dario0603/Unipi_boost_converter/README.md

# DC-DC Boost Converter with Closed-Loop Control

<p align="left">
  
  
  
  
</p>

Academic project developed for the **University of Pisa** focused on the design, loss analysis, small-signal dynamic modeling, and closed-loop control of a high-efficiency **DC-DC Boost Converter**.

---

## Project Specifications

* **Input Voltage ($V_{\text{in}}$):** 3.3 V
* **Output Voltage ($V_{\text{out}}$):** 12.0 V
* **Reference Voltage ($V_{\text{ref}}$):** 3.3 V
* **PWM Peak/Ramp Voltage:** 1.0 V
* **Switching Frequency:** 600 kHz
* **Load Resistance Range ($R_o$):** $100\Omega$ to $1000\Omega$
* **Operation Mode:** Continuous Conduction Mode (CCM)
* **Output Voltage Ripple:** < 0.1 $\cdot V_{\text{out}} = 12\text{ mV}$
* **Target Efficiency:** > 70% (Achieved: 87.5% to 94.3%)
* **Steady-State DC Relative Error:** < 1%
* **50 Hz Relative Error:** < 10%

---

## Power Stage Design & Component Selection

The power stage was dimensioned in worst-case operating conditions to counteract component derating and parasitic effects:

* **Inductor ($L_1$):** Coilcraft RFS1317-334KL ($330\mu\text{H}$, $\text{ESR} = 286\text{ m}\Omega$), guaranteeing CCM operation up to $7.2\text{ k}\Omega$ load.
* **Capacitor ($C_1$):** Panasonic 100SXE18M ($18\mu\text{F}$, $\text{ESR} = 30\text{ m}\Omega$, $100\text{ V}$) to meet the output ripple constraint.
* **Transistor ($M_1$):** Infineon IRFH7921 N-Channel MOSFET ($V_{\text{DS,max}} = 30\text{ V}$, $R_{\text{DS(on)}} = 8.5\text{ m}\Omega$).
* **Diode ($D_1$):** Infineon BAS3005A-02V Schottky Diode ($I_{\text{max}} = 500\text{ mA}$, $V_{\gamma} \approx 0.5\text{ V}$, $R_D = 267\text{ m}\Omega$).

| Ideal Converter Schematic | Lossy Converter Schematic |
| :---: | :---: |
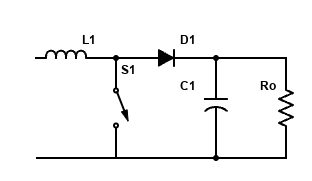
[picture p1: Relazione/img/Boost conv.png]
Ideal Boost Schematic
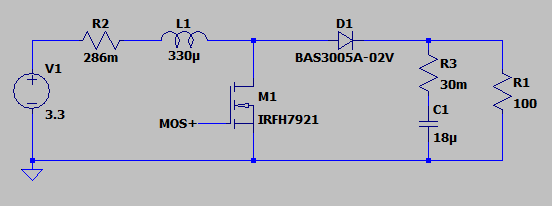
[picture p2: Relazione/img/Boost conv losses LTSpice.png]
Lossy Boost Schematic
|  |  |

---

## Small-Signal Modeling & Control Loop Design

To ensure closed-loop stability across full load variation, Has been derived control-to-output transfer function $G_{vd}(s)$, line-to-output $G_{vg}(s)$, and output impedance $Z_{\text{out}}(s)$.

Because the uncompensated loop $T_u(s)$ exhibits a negative phase margin ($\phi_{m} \in [-28.6^{\circ}, -2.95^{\circ}]$), an analog **Type-III Compensator** (2 zeros, 3 poles) was synthesized:

$$G_c(s) = \frac{\left(1 + \frac{s}{2\pi \cdot 0.25}\right)\left(1 + \frac{s}{2\pi \cdot 1000}\right)}{s \left(1 + \frac{s}{2\pi \cdot 60000}\right)\left(1 + \frac{s}{2\pi \cdot 600000}\right)}$$

* **Phase Margin ($\phi_m$):** $26.9^{\circ}$ (worst-case) to $63.0^{\circ}$
* **Gain Margin ($M_g$):** $3.2\text{ dB}$ (worst-case) to $23.2\text{ dB}$
* **Steady-State Error ($\epsilon_r$):** $0\%$ DC error, <10% at 50Hz

| Type-III Op-Amp Circuit Architecture | Open-Loop vs Compensated Bode Response |
| :---: | :---: |
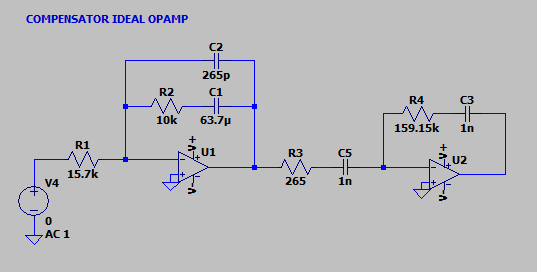
[picture p3: Relazione/img/Laplace compensatore opamp.png]
Type-III Compensator Circuit
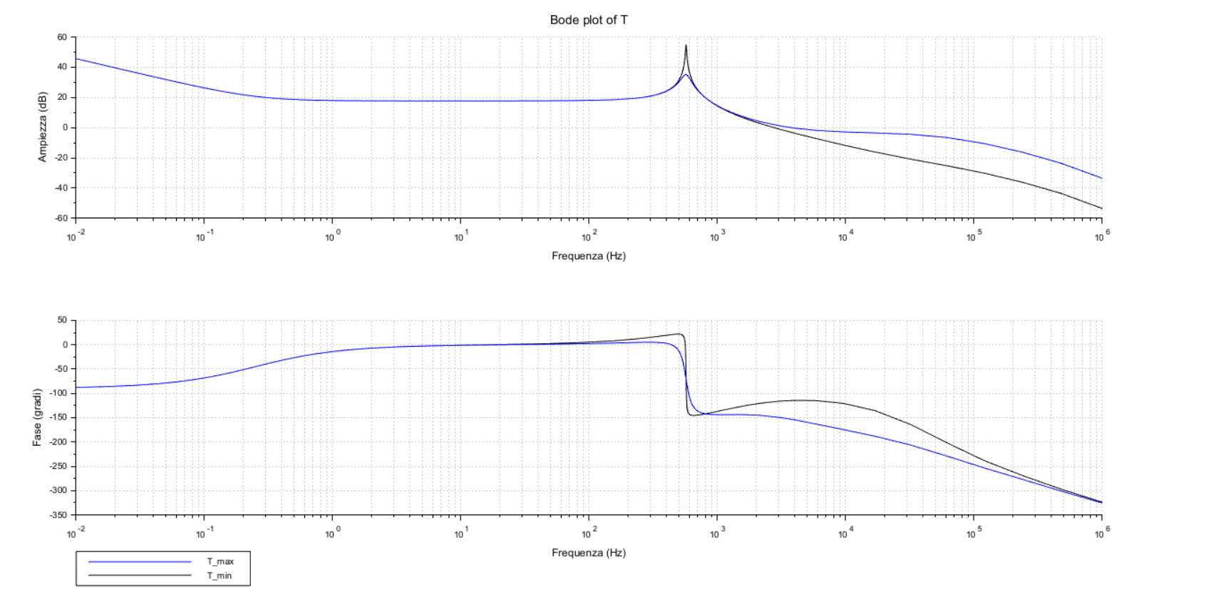
[picture p4: Relazione/img/bode diagrams CL.png]
Compensated Bode Diagrams
|  |  |

---

## Dynamic Simulations & Transient Response

Closed-loop stability and reference step tracking were validated using both **Scilab/Xcos** numerical block diagrams and full transient **LTspice** simulations.

### 1. Xcos Dynamic Models & Step Response

| System Model | Step Response Output |
| :---: | :---: |
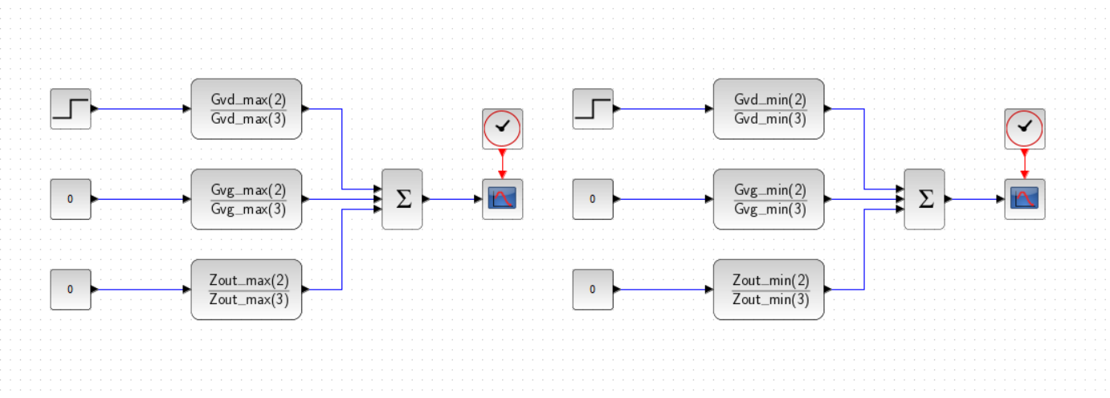
[picture p5: Relazione/img/XCOS modello open loop.png]
Xcos Open Loop Model
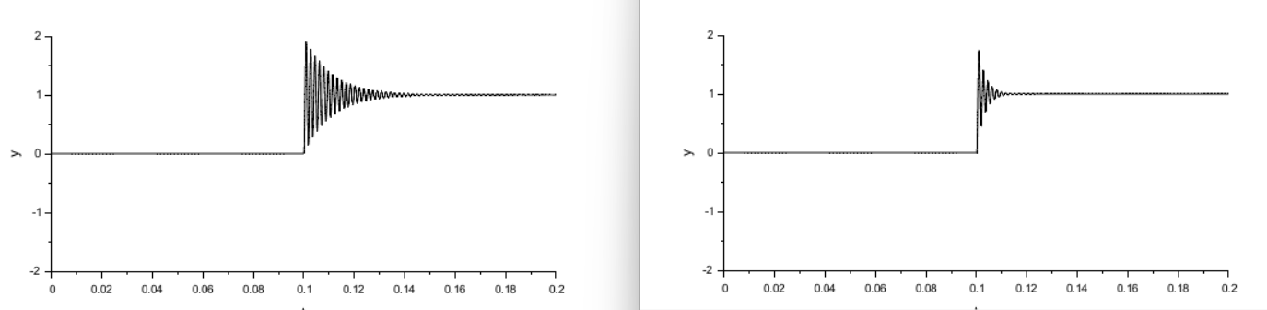
[picture p6: Relazione/img/XCOS risposta open loop.png]
Xcos Open Loop Response
| **Open-Loop Model**<br> | **Open-Loop Response**<br> |
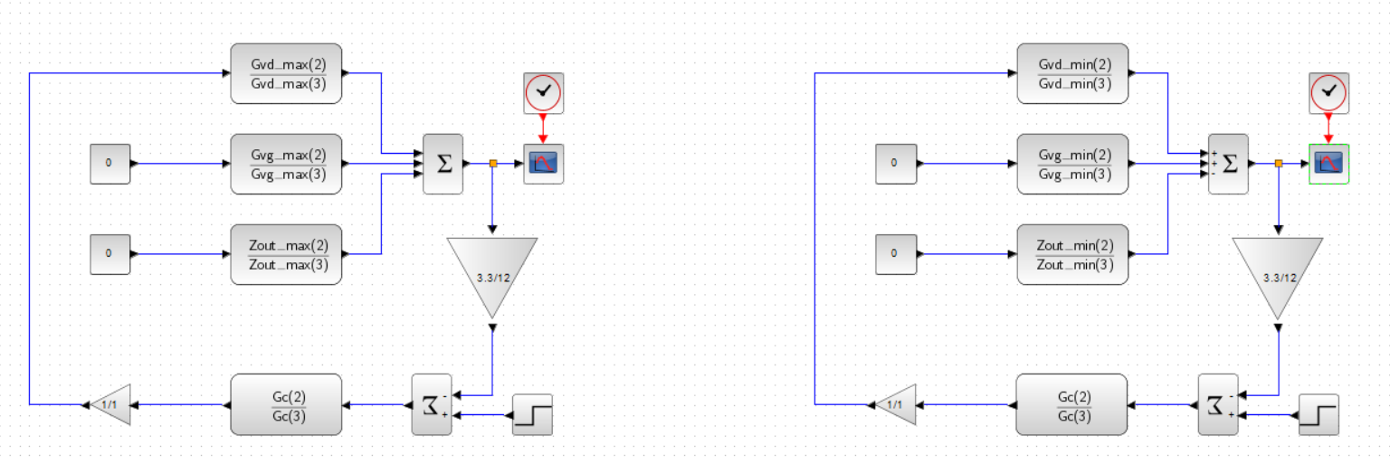
[picture p7: Relazione/img/XCOS modello closed loop.png]
Xcos Closed Loop Model
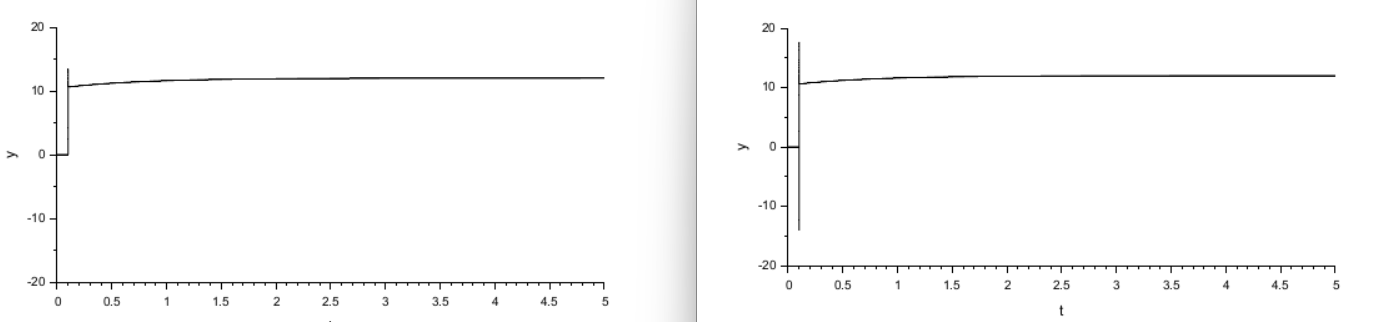
[picture p8: Relazione/img/XCOS risposta closed loop.png]
Xcos Closed Loop Response
| **Closed-Loop Model**<br> | **Closed-Loop Response**<br> |

---

### 2. Full Circuit LTspice Closed-Loop Transient Response

| LTspice Closed-Loop Transient Simulation |
| :---: |
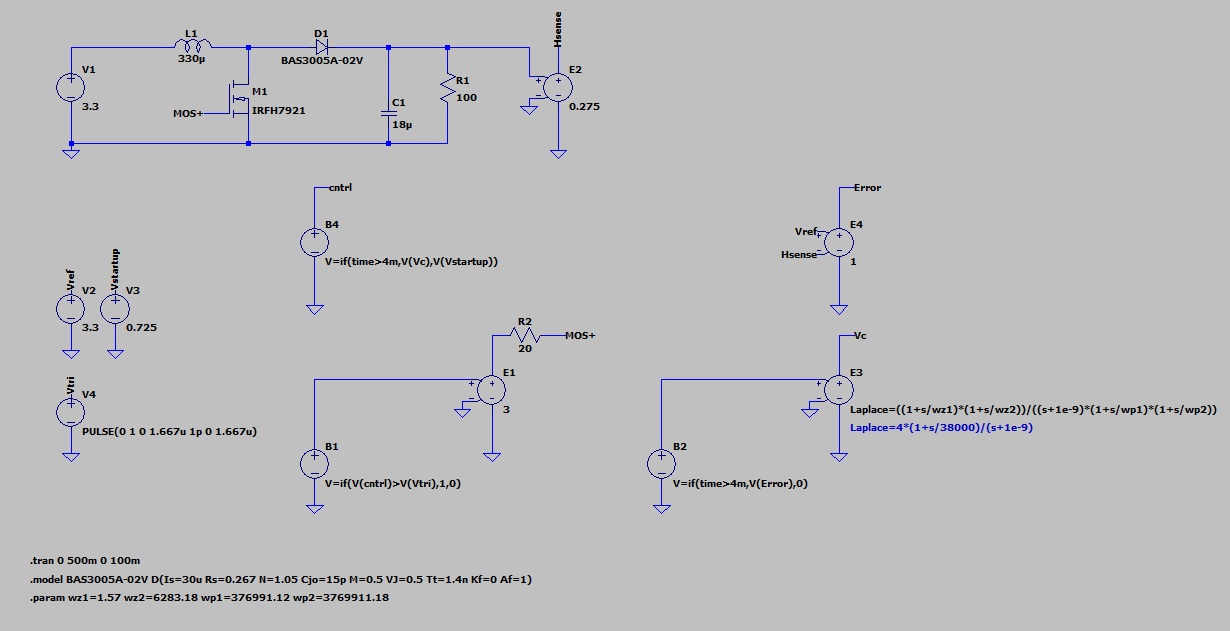
[picture p9: Relazione/img/simulazione anello chiuso.png]
LTspice Closed Loop Transient
|  |

---

## Repository Structure

```text
.
├── LTSpice/                                 # LTspice simulations (.asc, .raw)
├── Relazione/                               # Documentation & figures
│   ├── Boost_converter.pdf                  # PDF report
│   ├── main.tex                             # LaTeX source
│   └── img/                                 # Circuit schematics & plots
├── Scilab/                                  # Scilab scripts & Xcos models (.sci, .zcos)
└── README.md
