dario0603/Unipi_boost_converter/Relazione/Boost_converter.pdf

# Boost converter

Dario Aliberti

September 18, 2025

## 1 Specifiche tecniche

Vin = 3.3V
Vout = 12V
fSW = 600kHz
r ≤ 0.001 · Vout
Ro ∈ [100Ω, 1000Ω]
CCM mode
ϵr ≤ 1%
ϵr(50Hz) ≤ 10%
η > 70%
Vref = 3.3V
VM = 1V (Tensione alta segnale PWM)

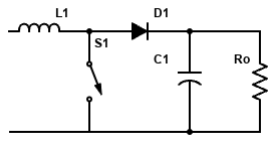
[picture p33: figure]

## 2 Steady state, lossless

Dalla condizione in steady state deriva che la media della tensione sull’induttore e della corrente nel condensatore durante un periodo di switch è nulla, quindi

⟨vL⟩Tsw = (1 − δ) (Vin − Vout) + δ Vin = Vin − (1 − δ) Vout = 0 V =⇒ Vout =

Vin
1 − δ

⟨ic⟩Tsw = (1 − δ)⟨iL − iout⟩Tsw − δ ⟨iout⟩Tsw = 0 A =⇒ Iout = Iin (1 − δ)

⟨iin⟩Tsw = ⟨iL⟩Tsw =⇒ Iout = Iin (1 − δ) = IL (1 − δ)

Da qui si può ricavare il valore del duty cycle per avere il corretto rapporto tra tensione in ingresso e tensione in uscita

Vout =

Vin
1 − δ

=⇒ 1 − δ =

Vin

Vout

≃ 0.275 =⇒ δ ≃ 0.725

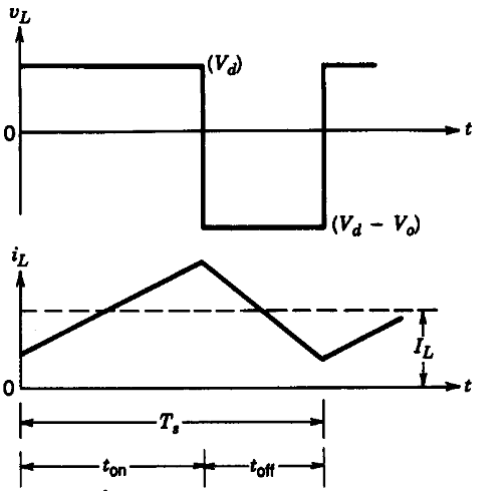
[picture p34: figure]

Durante il ton la iL ≃

Vin
L
- t, durante il tof f invece iL ≃

Vin−Vout
L
- t. Per rispettare la specifica di funzionamento CCM faccio in maniera tale che il ∆iL
2

sia sempre minore di IL, quindi considero il più basso valore assumibile da IL e impongo la condizione

∆iL
2

< ILmin

il valore di ILmin si ha in corrispondenza di Romax e Voutmin

ILmin = Ioutmin ·

1
1 − δ

=

Vout − r

Romax

·

1
1 − δ

≃

11.988 V
1000 Ω · 3.63 ≃ 43.593 mA

da qui posso ricavare la condizione di massima ∆iL con la quale dimensiono L

∆iL =

Vin
L
- δTsw < 2 · ILmin =⇒ L > Vin 2ILmin ·

δ

fsw

≃ 45.73µH per l’induttore è stato scelto il RFS1317-334KL: un induttore da 330µH con DCR di 286mΩ. Con un induttore di queste dimensioni il funzionamento in CCM è garantito fino ad un carico di

Rout ≃

Vout

Vin

Lfsw
δ(1 − δ)

≃ 7.2kΩ

Link al datasheet dell’induttore scelto

https://www.coilcraft.com/en-us/products/power/shielded-inductors/high-current-radial-lead/rfs/rfs1317/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 (https://www.coilcraft.com/en-us/products/power/shielded-inductors/high-current-radial-lead/rfs/rfs1317/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)

Adesso dimensioniamo anche il condensatore cercando di rispettare la specifica sul ripple della Vout

∆Vout ≃

Iout
C

δTsw =

Vout
RoC

δTsw =⇒

∆Vout

Vout

<

r

Vout

= 0.001 =⇒ C > Vout
r

·

δTsw
Ro

Anche qui considero il caso peggiore (ripple maggiore), ovvero quello con Ro minima

C > Vout
r

·

δTsw

Romin

≃ 12.083µF

per il condensatore è stato scelto il 100SXE18H: un condensatore elettrolitico da 18µF con tolleranza del 20% , una tensione massima di 100VDC e una resistenza serie equivalente di 30mΩ.

Link al datasheet del condensatore scelto

https://www.mouser.it/ProductDetail/Panasonic/100SXE18M%2b3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 (https://www.mouser.it/ProductDetail/Panasonic/100SXE18M%2b3)

I dati sono stati verificati con LTSpice utilizzando il circuito Figure 1

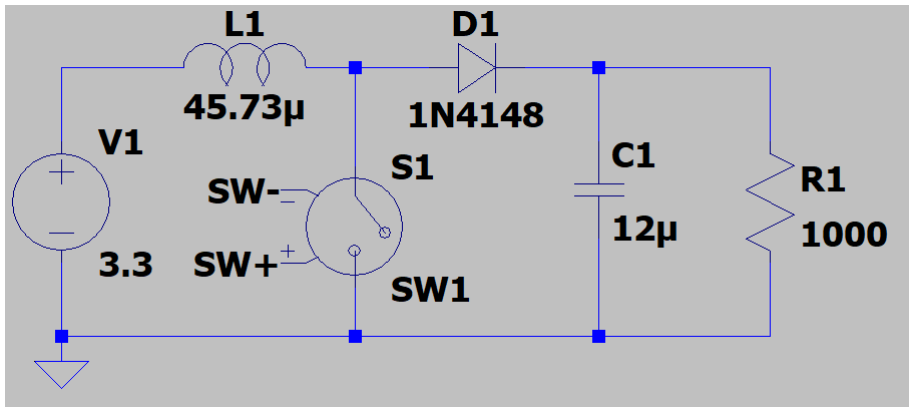
[picture p35: figure]

Figure 1: Circuito per la simulazione steady state, lossless

Prima è stata fatta la simulazione utilizzando Ro = 1000Ω e leggendo la corrente nell’induttore Figure 2


Figure 2: Simulazione corrente nell’induttore a regime

Dalla simulazione Figure 2, risulta che (l’onda blu è il segnale PWM, mentre l’onda verde è la corrente nell’induttore) il ∆iL ≃ 87.2mA che è all’incirca 2 · IL come calcolato in precedenza.

Poi è stata fatta la simulazione utilizzando Ro = 100Ω e leggendo la tensione in uscita Figure 3


Figure 3: Simulazione tensione di uscita a regime

Dalla simulazione Figure 3, risulta che (l’onda è la tensione di uscita dal convertitore) il ∆Vout ≃ 0.013V e considerando che r < 0.001 · Vout = 0.012V anche qui il risultato è concorde con i calcoli.
Per mantenere del margine con i dati teorici, per il condensatore e l’induttore sono stati scelti dei valori maggiori rispetto ai minimi calcolati, in modo da contrastare il derating dei componenti e compensare gli effetti dei parametri parassiti.

## 3 Steady state, con perdite

Per l’analisi delle perdite devo introdurre tutti i componenti dissipativi del circuito ideale come mostrato in Figure 4


Figure 4: Boost converter con perdite

applicando le stesse formule di prima, siamo in grado di ricavare il V CR =

Vout
Vin

con perdite e il
rendimento η.

⟨vL⟩Tsw = (1 − δ) [Vin − RLESR · IL − (Vout + Vγ + RDon · IL)] + δ [Vin − (RLESR + RMOS) · IL]
= 0V

⟨ic⟩Tsw = (1 − δ)⟨iL − iout⟩Tsw − δ ⟨iout⟩Tsw = 0 A =⇒ Iout = Iin (1 − δ)

⟨iin⟩Tsw = ⟨iL⟩Tsw =⇒ Iout = Iin (1 − δ) = IL (1 − δ)

Da cui si può ricavare la relazione ingresso uscita del convertitore

Vout =

Vin
1 − δ

− Vγ −

δ
1 − δ

RMOS +

1
1 − δ

RLESR + RDon
·

Iout
1 − δ

=

Vin
1 − δ

− Vγ − ReqIout

da queste formule si può arrivare al modello semplificato del Boost converter con perdite che è il circuito mostrato in Figure 5


Figure 5: Circuito equivalente con perdite

da cui si ricava il V CR con perdite e il rendimento

V CR =

Vout

Vin

=

1

Vin

·

Vin
1 − δ

− Vγ

·

Ro
Ro + Req

=

1
1 − δ

·

1 −

Vγ

Vin

(1 − δ)
1 + δ (1−δ)
2

RMOS
Ro

+

RLESR
(1−δ)

2

1
Ro

+

RDon
Ro·(1−δ)
Iout

Iin

=

Iout
IL

= 1 − δ

il rendimento si calcola come

η =

Pout

Pin

=

VoutIout

VinIin

= V CRIout

Iin

=

1 −

Vγ

Vin

(1 − δ)
1 + δ (1−δ)
2

RMOS
Ro

+

RLESR
(1−δ)

2

1
Ro

+

RDon
Ro·(1−δ)


Figure 6: Grafico rendimento al variare del duty cycle

Si nota come ci sia una parte del rendimento, dominata dalle perdite per conduzione, dove la Ploss α I²
out
e Pout α Iout, che è la parte in cui il rendimento decresce all’aumentare del duty cycle e una parte dominata dalle perdite di switching, quelle dovute alle capacità parassite del MOS. Per la scelta del MOS e del diodo, considero le massime tensioni e correnti che devono sopportare e cerco le soluzioni con le capacità e le resistenze parassite più piccole.

VMAXMOS = Vout = 12V
VMAXdiodo = Vout − Vin = 8.7V
IMAXMOS = ILMAX + ∆iL = IoutMAX + ∆iL ≃ 202mA IMAXdiodo = IoutMAX ≃ 120mA

Il transistor scelto è il IRFH7921: un N-MOS da 34A con una tensione VDS massima di 30V e una resistenza drain source di 8.5mΩ.

Link al datasheet del transistor scelto

https://www.infineon.com/part/IRFH7921

Il diodo scelto è il BAS3005A-02V: un diodo da 500mA con una tensione Vγ massima di 500mV e una resistenza serie di 267mΩ ricavata dal grafico ( VF , IF ) presente nel datasheet.

Link al datasheet del diodo scelto

https://www.infineon.com/part/BAS3005A-02V

Usando la formula del rendimento trovata sopra risulta che η ∈ [91% , 95% ]. La stima è stata fatta trascurando la resistenza serie del condensatore e trascurando le capacità del transistor e del diodo. Calcoliamo le potenze dissipate per i vari componenti

Le perdite per switching sono:

PMOSswitching = fsw ·

Cgs∆V

2
gs + Cgd∆V

2
gd + Cds∆V

2
ds
≃ 33.1mW

Le perdite per conduzione sono:

PMOS = δRMOSon
Iout
1 − δ

2

PD = (1 − δ)VγIout + (1 − δ)RDonI

2
out

PL = RLESR
Iout
1 − δ

2

Pc =

r

2

RCESR

Così si arriva ad un rendimento effettivo compreso tra η ∈ [89.7% , 94.3% ] che essendo sempre maggiore del 70% rispetta, almeno analiticamente, le specifiche, adesso procediamo alla verifica con il simulatore.

Analiticamente risulta che la potenza persa totale nei vari componenti sia distribuita secondo il grafico a torta in Figure 7

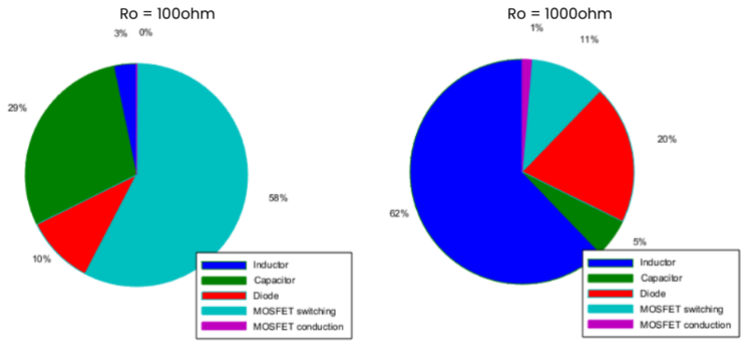
[picture p36: figure]

Figure 7: Grafico della percentuale di potenza dissipata nei vari componenti del circuito

Il circuito utilizzato per effettuare la simulazione è quello in Figure 8

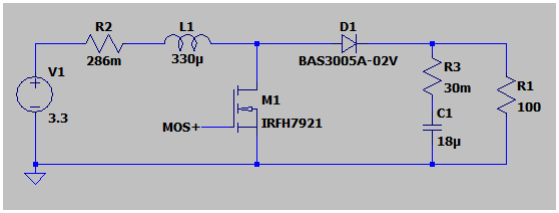
[picture p37: figure]

Figure 8: Circuito per il calcolo dell’efficienza

Durante la simulazione è stato calcolato il rendimento (calcolato come rapporto tra la potenza media dissipata sul carico diviso la potenza media erogata dal generatore) del circuito a regime per un carico di 100Ω e per un carico di 1000Ω. Con un carico di 100Ω ho un rendimento del η ≃ 90.9%, mentre con un carico di 1000Ω ho un rendimento del η ≃ 87.5%

## 4 Modello dinamico

Rimuovendo l’ipotesi di steady state, le forme d’onda possono variare da un periodo di switching all’altro, quindi si analizzano due termini:

- Valor medio del segnale, ipotizzato costante per ogni periodo di switch
- Termini del prim’ordine, ovvero variazioni delle grandezze in gioco all’interno di un periodo di switching

Le grandezze di controllo vengono rappresentate quindi come somma di X (valor medio) e ˜x (contributo del prim’ordine)

< x > = X + ˜x
< x >< y > = (X + ˜x)(Y + ỹ) = XY + Xy˜ + Y x˜ + ˜xy˜ ≃ XY + (Xy˜ + Y x˜)

Riprendiamo adesso il circuito Figure 4 e applichiamo stavolta le relazioni costitutive dell’induttore e del condensatore

< vL >= L

d
dt < iL >

< ic >= L

d
dt < vc >

< iin >=< iL >

Riscrivendo le grandezze in gioco come somma dei contributi di ordine inferiore al secondo si ottiene:

- < vL >= VL + ṽL
- < ic >= Ic + ĩ
c
- δ = D + ˜δ

< vL > = δ < vin > +(1 − δ)(< vin > − < vout >) =⇒

VL + ṽL ≃ Vin − (1 − D)Vout + ˜δVout + ṽin − (1 − D) ṽout = L

d
dti˜L

< ic > = −δ < iout > +(1 − δ)(< iL > − < iout >) =⇒

Ic + ĩ

c ≃ −Iout + (1 − D)IL − ˜δIL − i ˜
out + (1 − D)i˜L = C

d
dtvout ˜

< iL > =< iin >

Da qui, separando i termini di ordine 0 dai termini di ordine 1, ottengo sia le relazioni trovate con il modello steady state lossless, sia le relazioni utili per progettare il sistema di controllo.

Vin − (1 − D)Vout = L

d
dtVL = 0V ←− VL e una grandezza costante nel periodo T ` | sw

˜δVout + ṽin − (1 − D) ṽout = L

d
dtv˜L

−Iout + (1 − D)IL = C

d
dtVc = 0A ←− Ic e una grandezza costante nel periodo T ` | sw

−˜δIL − i ˜
out + (1 − D)i˜L = C

d
dtv˜c

IL = Iin

i˜L = ĩ
in

Adesso possiamo disegnare il modello circuitale lineare tempo invariante che descrive le variazioni delle grandezze in gioco in un periodo di switching Figure 9

Figure 9: Modello LTI delle grandezze al prim’ordine

portando il modello trovato in forma canonica, quindi con il modello del trasformatore in continua, tutti i generatori a sinistra del trasformatore e tutti i componenti passivi a destra si ottiene Figure 10


Figure 10: Modello LTI delle grandezze al prim’ordine

e(s) = ˜δVout − ˜δIL

sL
1 − D

j(s) =

˜δ
1 − D

IL

Leq =

L
(1 − D)

2

M(D) = 1 1 − D

Definisco adesso la funzione di trasferimento del filtro passa basso in uscita dal trasformatore in continua Figure 11


Figure 11: Circuito di filtro in uscita

HLP F (s) =

R
1+sRC
R
1+sRC + sLeq

=

1
(

1
R + sC)sLeq + 1

=

(1 − D)

2
(

1
R + sC)sL + (1 − D)

2

Posso trovare adesso i vari guadagni necessari a costruire lo schema a blocchi del sistema ad anello aperto da controllare.

Gvd =

vout ˜
˜δ

i õut=0A
vĩn=0V

=

e(s)
˜δ

M(D)HLP F (s)

Gvg =

vout ˜
vĩn

i õut=0A
δ˜=0

= M(D)HLP F (s)

Zout =

vout ˜

iout

δ˜=0
vĩn=0V

= sLeq// 1
sC //R =

sL
(1 − D)

2 HLP F (s)

Lavorando sulle funzioni di trasferimento calcolate si possono portare in forma canonica

Gvd =

Vout
1 − D

1 − s

LIL
Vout(1−D)
1 + s

L
R(1−D)

2 + s

2 LC
(1−D)

2

= K

1 − s

1
ωz
1 + s
Qωo

+

s

2
ω²
o

K =

Vout
1 − D

≃ 43.63V

ωz =

Vout(1 − D)
LIL

=

Vout(1 − D)
L

1 − D

Iout

≃

(
22916.67 rad
s ←− R = 100Ω
229166.67 rad
s ←− R = 1000Ω

ωo =

1 − D
√
LC

≃ 3568.12

rad
s

Q =

R
L

(1 − D)

2
ωo

= R

r
C
L

(1 − D) ≃

(
6.423 rad
s ←− R = 100Ω
64.226 rad
s ←− R = 1000Ω

Gvg =

1
1 − D

1
1 + s

L
R

1
(1−D)

2 + s

2 LC
(1−D)

2

= K

1
1 + s
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
1 − D

≃ 3.63

ωo =

1 − D
√
LC

≃ 3568.12

rad
s

Q =

R(1 − D)

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
(1 − D) ≃

(
6.423 rad
s ←− R = 100Ω
64.226 rad
s ←− R = 1000Ω

Zout =

L
(1 − D)

2

s
1 + s

L
R

1
(1−D)

2 + s

2 LC
(1−D)

2

= K

s
1 + s
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
(1 − D)

2

≃ 4.36 · 10⁻³H

ωo =

1 − D
√
LC

≃ 3568.12

rad
s

Q =

R(1 − D)

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
(1 − D) ≃

(
6.423 rad
s ←− R = 100Ω
64.226 rad
s ←− R = 1000Ω

## 5 Progettazione del feedback

Partendo dalle funzioni di trasferimento calcolate prima, posso disegnare lo schema a blocchi del sistema da controllare e del sistema retroazionato per il controllo


Figure 12: Schema a blocchi boost converter con feedback

Scrivo la funzione di trasferimento della tensione in uscita ad anello chiuso

vout ˜ = ˜δGvd(s) + ṽinGvg(s) − i ˜
outZout(s)

ϵ˜ = ṽoutH(s) − vref ˜

˜δ =

Gc(s)
VM

ϵ˜ =

Gc(s)
VM

(

˜ voutH(s) − vref ˜ )

vout ˜ =

Gc(s)Gvd(s)
VM

( ˜ vref − vout ˜ H(s)) + ṽinGvg(s) − i ˜
outZout(s)

T(s) = Gc(s)Gvd(s)
VM

H(s)

vout ˜ =

T(s)
1 + T(s)

vref ˜
H(s)

+ ṽin

Gvg(s)
1 + T(s)

− i ˜
out

Zout(s)
1 + T(s)

Le funzioni di trasferimento ad anello chiuso sono quindi

GvgCL (s) = Gvg(s)
1 + T(s)

ZoutCL (s) = Zout(s)
1 + T(s)

vout ˜ =

T(s)
1 + T(s)

vref ˜
H(s)

+ ṽinGvgCL (s) − i ˜
outZoutCL (s)


Figure 13: Diagrammi di bode delle funzioni di trasferimento calcolate, ad anello aperto

La funzione di trasferimento su cui dobbiamo lavorare per garantire la stabilità del sistema è la T(s) che possiamo scrivere come Tu(s)Gc(s) dove Tu(s) è la funzione di trasferimento, del sistema non com-pensato, che lega la tensione di uscita con il duty cycle del segnale PWM di controllo dell’interruttore. Per la progettazione del controllore partiamo graficando la funzione di trasferimento di Tu(s), ovvero

Tu(s) = Gvd(s)
VM

H(s)

con VM = 1V , ricavato dalle specifiche, e H(s) = Vref

Vout

= 0.275


Figure 14: Diagramma di bode della funzione di trasferimento Tu(s)

Si nota come Tu(s) non sia stabile ad anello chiuso, infatti il margine di fase e di guadagno sono

ϕmmin = −28.6° ϕmmax = −2.95°

Mgmin = −21.6dB Mgmax = −21.6dB

quindi per qualunque valore della resistenza di carico compreso nel range delle specifiche, entrambi i margini sono negativi. Per stabilizzare la risposta ad anello chiuso e rispettare la specifica di ϵr ≤ 1% a regime si può utilizzare un controllore PI.
Per cercare di rispettare la specifica di ϵr(50Hz) ≤ 10% si cerca di portare il modulo di T(s) abbastanza in basso da avere ω

∗ prima di ωo, dove con ω

∗
si intende la pulsazione per cui |T(ω

∗
)|dB = 0dB, così
da avere un margine di fase positivo e prossimo a 90°, ma comunque cercando di mantenere ω
∗
il più
in alto possibile. Il valore massimo di KT si ha quando il picco di |T(s)| in ωo tocca l’asse a 0dB, poichè sopra quella soglia avrei che T(s) passa più volte per 0dB, quindi

KT

|Tu(0)|Qmax
s

< 1 =⇒ KT < 4.63

La frequenza di zero del controllore va piazzata dopo la pulsazione ωo, quindi un esempio di controllore utilizzabile è il seguente

GcP I (s) = 4
s

(1 + s 2π · 6000
)

Calcoliamo adesso l’errore ϵr(50Hz) con questo controllore per vedere se la specifica è rispettata

T(50Hz) ≃ Tu(0) | GcP I (50Hz) ≃

4
jω
ω=2π·50Hz

1
1 + T(jω)

≃

s
ω²
ω² + (4 · Tu(0))²

=⇒

1
1 + T(jω)
ω=2π·50Hz

≃ 0.78 > 0.1

quindi la specifica di ϵr(50Hz) ≤ 10% non è rispettata con questo tipo di controllore.
Per riuscire a rispettare anche questa specifica si opta per un controllore a due zeri e tre poli di cui uno nell’origine, quindi un controllore che ha la forma seguente

Gc(s) =

(1 + s
ωz1

)(1 + s
ωz2

)
s(1 + s
ωp1

)(1 + s
ωp2

)

Questa tipologia di controllore è approfondita al seguente link

Link all’analisi del compensatore scelto, fatta da Texas Instruments

https://www.ti.com/lit/an/slva662/slva662.pdf?ts=1755498934755&ref_url=https%253A%252F%252Fwww.google.com%252F (https://www.ti.com/lit/an/slva662/slva662.pdf?ts=1755498934755)


Figure 15: Esempio di compensatore utilizzato preso dal sito di Texas Instruments

Per il dimensionamento del controllore scelto si parte dagli zeri della funzione di trasferimento.
Il primo zero serve per appiattire T(s) prima della pulsazione di risonanza ωo e dovrà essere tale da garantire un |T(50Hz)| sufficiente ad avere ϵr(50Hz) < 10%, quindi

1
1 + T(50Hz)
dB

< −20dB =⇒ |1 + T(50Hz)|dB > 20dB

visto che |1 + T(50Hz)|dB > |T(50Hz)|dB la specifica è rispettata anche se |T(50Hz)|dB > 20dB, quindi

Tu(0)

ωz1

> 10 =⇒ ωz1 <

Tu(0)
≃ 1.2 =⇒ fz1 =

ωz1
2π

≃ 0.19

Per quanto riguarda il secondo zero, è quello che permette di avere un miglioramento del margine di fase alzando la fase e lasciando invariato il modulo di T(s) in corrispondenza di ω

∗
, quindi deve essere
tale che |Gc(f

∗
)| = 1.
Per prima cosa calcolo il valore di ω

∗

Tu(0)
(1 + jω∗
ωo

)

2

= 1 =⇒ ω

∗ = ωo

p

Tu(0) − 1 ≃ 11834rad
s

=⇒ f

∗ =

ω

∗
2π

≃ 1883Hz

una volta calcolato il valore di ω

∗ devo posizonare lo zero in modo tale che |Gc(f

∗
)| = 1

Gc(50Hz)

1 +

jω∗

ωz2

= 1 =⇒

1
|Gc(50Hz)|

2 = 1 +

ω

∗2

ω

2
z2

=⇒ ωz2 = ω

∗

s
1

1
|Gc(50Hz)| − 1

≃ 17840rad
s

=⇒ fz2 =

ωz2
2π

≃ 2839Hz

Una volta posizionati gli zeri, i poli basta piazzarli a frequenza più alta di ω

∗
, nel nostro caso sono
stati posizionati a 3 · 10⁵ rad
s

e a 3 · 10⁶ rad
s

, quindi all’incirca due decadi più in là dello zero a più alta frequenza.
Il controllore è stato poi simulato e i parametri calcolati sopra sono stati aggiustati in modo da migliorare il margine di fase e di guadagno della funzione di trasferimento reale (non asintotica, che è quella che è stata analizzata per dimensionare il controllore).
Il controllore utilizzato è il seguente
Gc(s) = | (1 + | s
2π0.25 )(1 + | s
2π1000 )
| s(1 + | s
2π60000 )(1 + | s
2π600000 )

dalla simulazione, la funzione di trasferimento T(s) controllata è quella in Figure 16


Figure 16: funzione di trasferimento di T(s) con il compensatore dimensionato

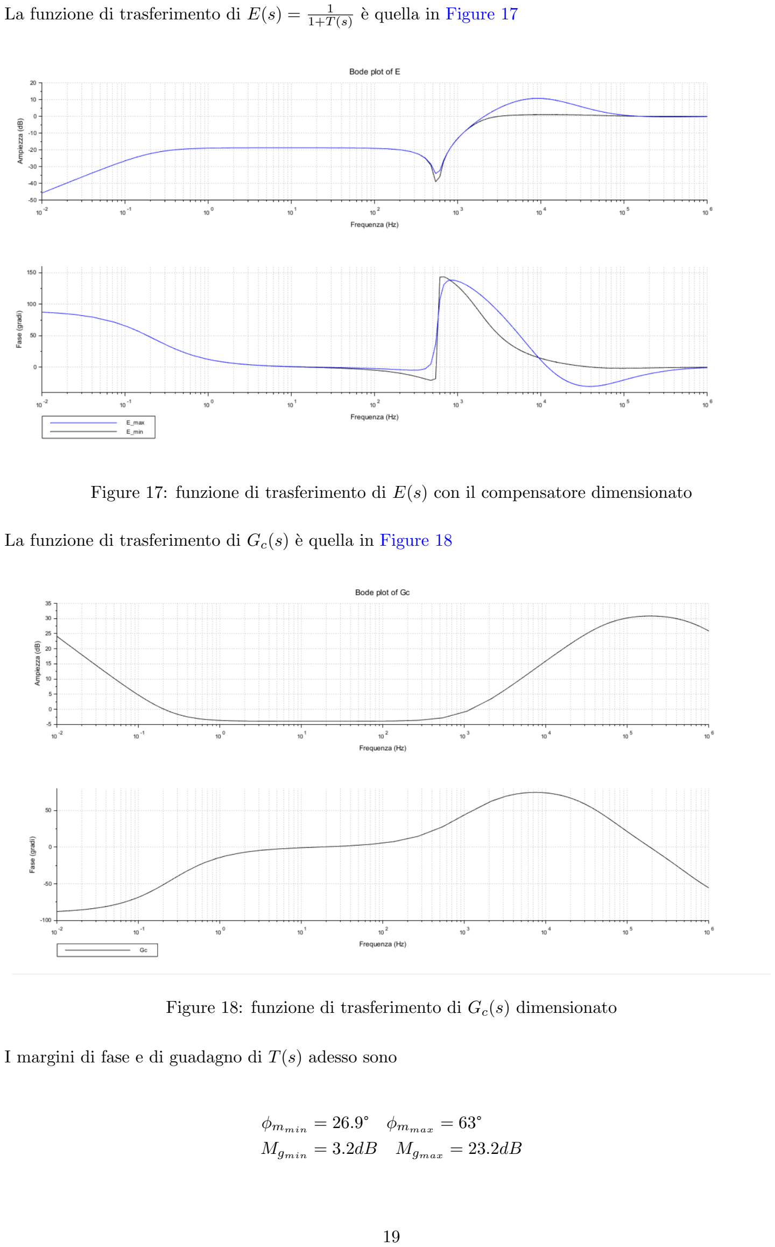
[picture p38: page 19]

La funzione di trasferimento di E(s) = 1 1+T(s) è quella in Figure 17

Figure 17: funzione di trasferimento di E(s) con il compensatore dimensionato

La funzione di trasferimento di Gc(s) è quella in Figure 18

Figure 18: funzione di trasferimento di Gc(s) dimensionato

I margini di fase e di guadagno di T(s) adesso sono

ϕmmin = 26.9° ϕmmax = 63°

Mgmin = 3.2dB Mgmax = 23.2dB quindi oltre ad essere tutti positivi (sistema retroazionato stabile per ogni condizione di carico com-presa nelle specifiche) ho all’incirca 3.2dB di margine di guadagno e 26.9° di margine di fase nel caso peggiore. L’errore a regime è nullo, poichè il controllore ha un polo nell’origine, quindi rispetta la condizione ϵr ≤ 1% e a 50Hz ho che |ϵr(50Hz)|dB ≃ −20dB =⇒ ϵr(50Hz) ≃ 0.1 quindi è rispettata anche la specifica di ϵr(50Hz) ≤ 10% .

## 6 Simulazione circuito di feedback

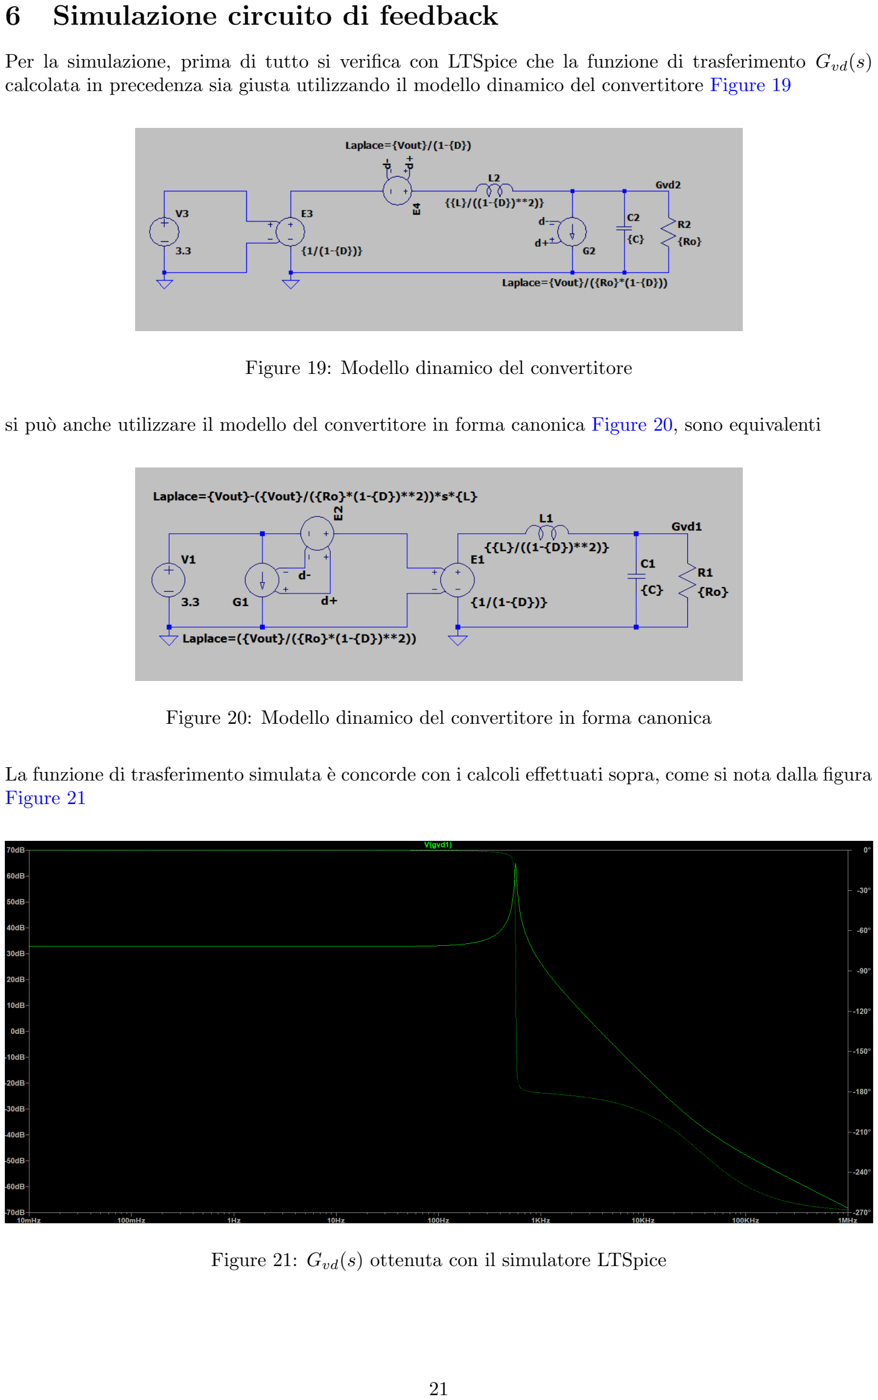
[picture p39: page 21]

Per la simulazione, prima di tutto si verifica con LTSpice che la funzione di trasferimento Gvd(s) calcolata in precedenza sia giusta utilizzando il modello dinamico del convertitore Figure 19

Figure 19: Modello dinamico del convertitore

si può anche utilizzare il modello del convertitore in forma canonica Figure 20, sono equivalenti

Figure 20: Modello dinamico del convertitore in forma canonica

La funzione di trasferimento simulata è concorde con i calcoli effettuati sopra, come si nota dalla figura Figure 21

Figure 21: Gvd(s) ottenuta con il simulatore LTSpice

Adesso valutiamo la risposta al gradino del sistema non retroazionato e per fare questo usiamo Xcos (un tool di Scilab). Il sistema simulato è il seguente Figure 22


Figure 22: Sistema ad anello aperto simulato su Xcos

Mandiamo in ingresso al blocco Gvd(s) una sollecitazione a gradino di ampiezza 1 Gvd(0) in modo da avere una risposta che a regime si assesta ad un valore unitario, mentre mandiamo un ingresso nullo in ingresso ai blocchi Zout(s) e Gvg(s). Il risultato della simulazione è il seguente Figure 23, le risposte sono due, una ottenuta con un carico di Rout = 100Ω e una con un carico di Rout = 1000Ω, quindi ottenute agli estremi di funzionamento nominale del convertitore.


Figure 23: Risposta al gradino sistema ad anello aperto

Chiudendo il sistema in feedback con il controllore Gc(s) calcolato precedentemente la risposta cambia, quindi si simula la risposta del sistema ad un gradino da 0V a 3.3V della Vref .
Il modello simulato è quello in figura Figure 24

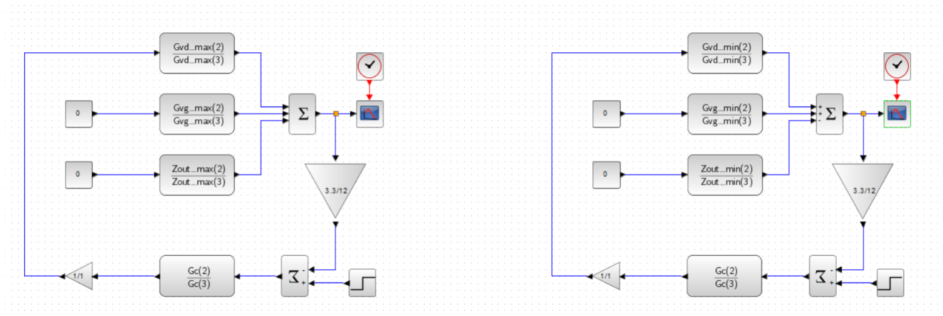
[picture p40: figure]

Figure 24: Sistema ad anello chiuso simulato su Xcos

La risposta al gradino si ottiene, come per il caso ad anello aperto, mettendo un ingresso nullo ai blocchi Gvg(s) e Zout(s) e collegando in retroazione il compensatore al blocco Gvd(s).
La risposta ad anello chiuso è quella in figura Figure 25, ottenuta anche qui per un carico Rout = 100Ω e Rout = 1000Ω.

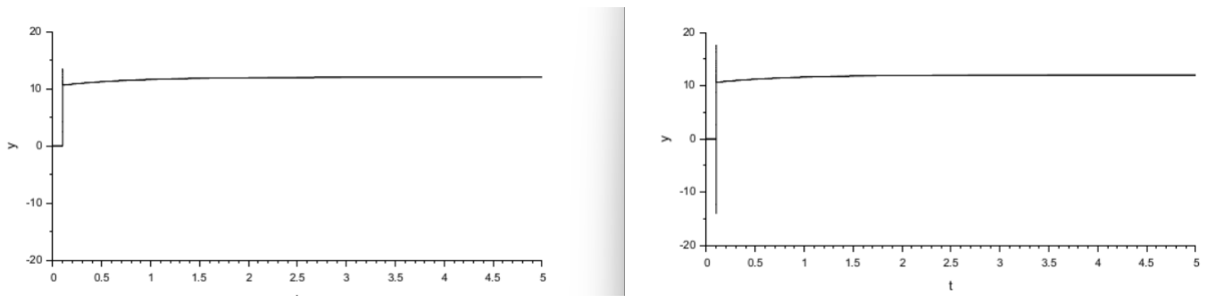
[picture p41: figure]

Figure 25: Risposta al gradino sistema ad anello chiuso

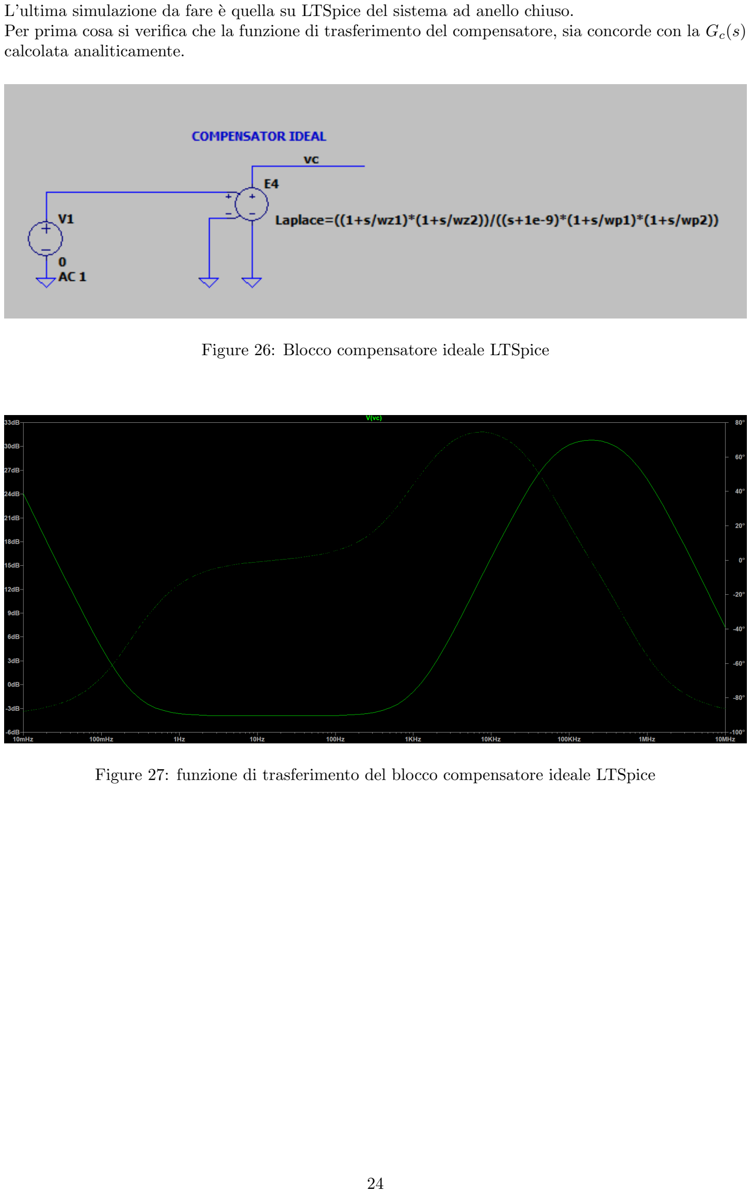
[picture p42: page 24]

L’ultima simulazione da fare è quella su LTSpice del sistema ad anello chiuso.
Per prima cosa si verifica che la funzione di trasferimento del compensatore, sia concorde con la Gc(s) calcolata analiticamente.

Figure 26: Blocco compensatore ideale LTSpice

Figure 27: funzione di trasferimento del blocco compensatore ideale LTSpice

Dopo aver verificato che il compensatore abbia la funzione di trasferimento calcolata analiticamente, si simula tutto il sistema retroazionato con il controllore scelto Gc(s).
Il circuito simulato è quello in figura Figure 28


Figure 28: Circuito utilizzato su LTSpice per effettuare la simulazione del sistema retroazionato

Dalla simulazione risulta che la tensione in uscita del convertitore tende alla tensione Vout e la tensione Verr tende a zero a regime. Con un carico di Ro = 100Ω si arriva a regime dopo circa 1s.


Figure 29: Tensione Vout (onda verde) e tensione Verr (onda blu)
