dario0603/Unipi_boost_converter/Relazione/img/Compensatore III opamp.png

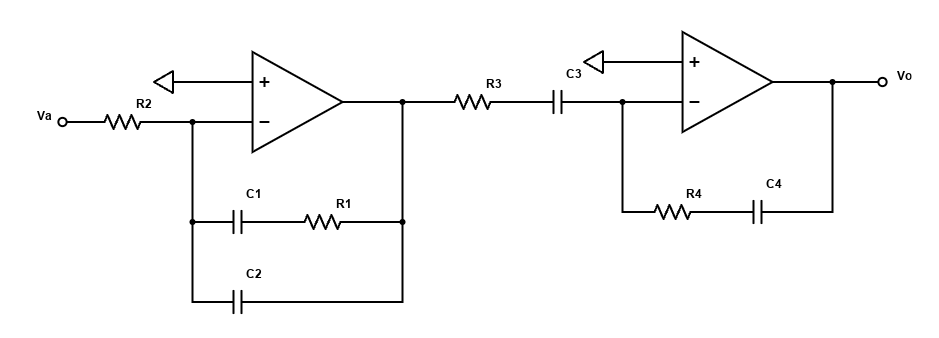
Relazione/img/Compensatore III opamp.png
