dario0603/Unipi_boost_converter/Relazione/img/eff_100ohm.png

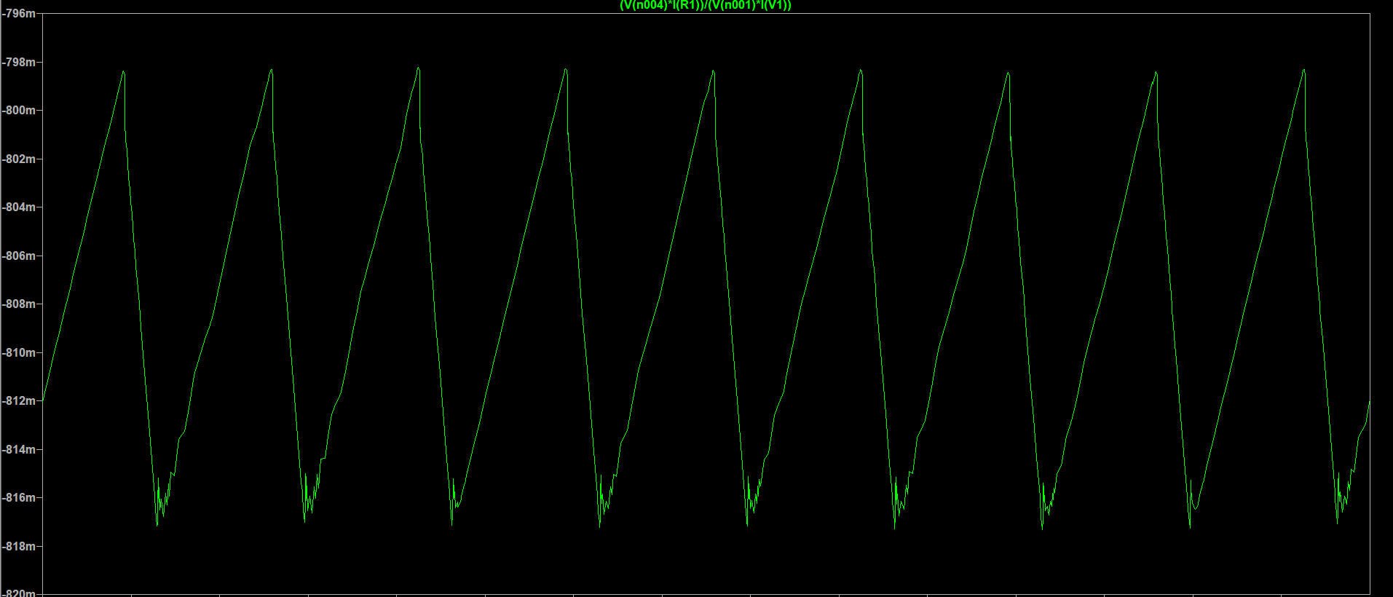
Relazione/img/eff_100ohm.png
