dario0603/Unipi_boost_converter/Relazione/img/eff_1000ohm.png

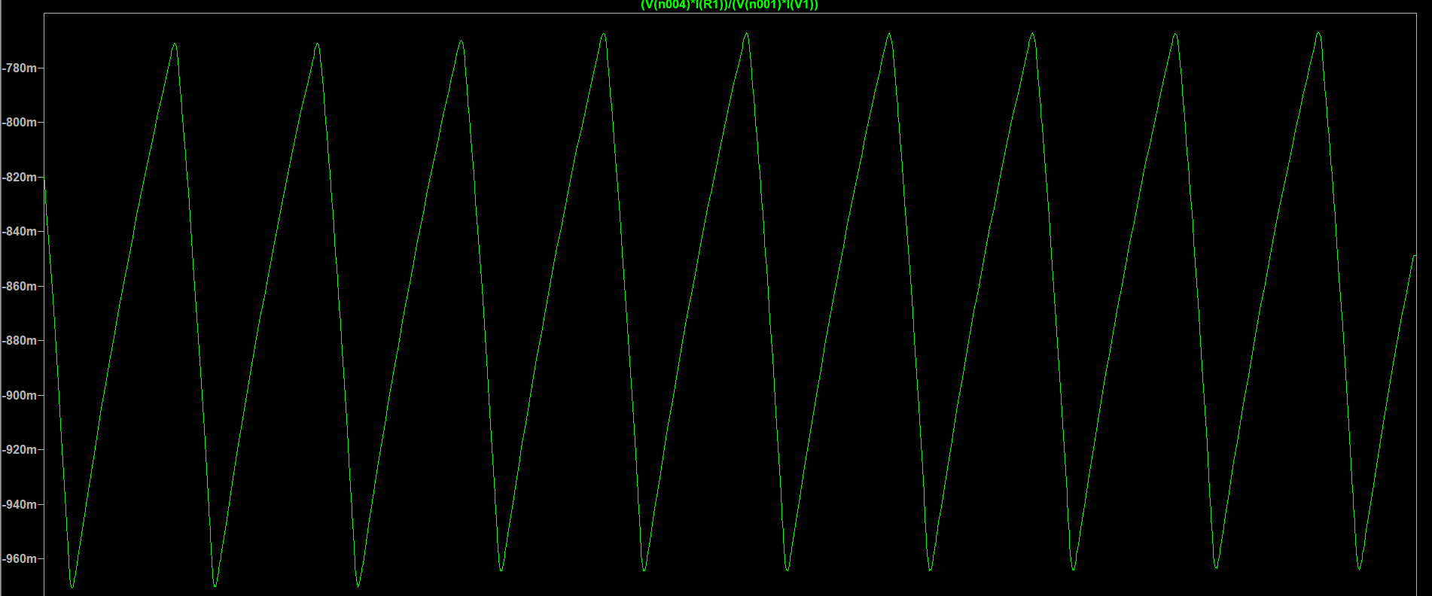
Relazione/img/eff_1000ohm.png
