dario0603/Unipi_boost_converter/LTSpice/CompensatorFDT.asc

C1: cap; 63.7µ
C2: cap; 265p
C3: cap; 1n
C5: cap; 1n
E4: e; Laplace=((1+s/wz1)*(1+s/wz2))/((s+1e-9)*(1+s/wp1)*(1+s/wp2))
R1: res; 15.7k
R2: res; 10k
R3: res; 265
R4: res; 159.15k
U1: UniversalOpAmp
U2: UniversalOpAmp
V1: voltage; 0; AC 1
V2: voltage; 12
V3: voltage; 12
V4: voltage; 0; AC 1
Named nets: vc, 0, V+, V-
.param wz1=1.57 wz2=6283.18 wp1=376991.12 wp2=3769911.18
COMPENSATOR IDEAL
.ac dec 10 1e-2 1e7
COMPENSATOR IDEAL OPAMP
