dario0603/Unipi_boost_converter/LTSpice/Draft1.asc

C1: cap; 1n
C2: cap; 1n
I1: current; 1m
L1: ind; 10µ
R1: res; 100
S1: sw; SW1
S2: sw; SW1
V1: voltage; 10v
V2: voltage; PWL(0 0 10m 1 10.01m 1)
V3: voltage; PWL(0 1 10m 1 10.01m 0)
Named nets: 0, a, b
.tran 0 10m 0 100u
.model SW1 SW(Ron=0.1 Roff=1MEG Vt=0.5)
