dario0603/Unipi_boost_converter/LTSpice/FDT closed loop.asc

B1: bv; V=if(V(cntrl)>V(Vtri),1,0)
B2: bv; V=if(time>4m,V(Error),0)
B4: bv; V=if(time>4m,V(Vc),V(Vstartup))
C1: cap; 18µ
D1: diode; BAS3005A-02V
E1: e; 3
E2: e; 0.275
E3: e; Laplace=((1+s/wz1)*(1+s/wz2))/((s+1e-9)*(1+s/wp1)*(1+s/wp2))
E4: e; 1
L1: ind; 330µ
M1: nmos; IRFH7921
R1: res; 100
R2: res; 20
V1: voltage; 3.3
V2: voltage; 3.3
V3: voltage; 0.725
V4: voltage; PULSE(0 1 0 1.667u 1p 0 1.667u)
Named nets: MOS+, 0, Vtri, Vref, Hsense, Error, Vc, Vstartup, cntrl
.tran 0 500m 0 100m
.model BAS3005A-02V D(Is=30u Rs=0.267 N=1.05 Cjo=15p M=0.5 VJ=0.5 Tt=1.4n Kf=0 Af=1)
.param wz1=1.57 wz2=6283.18 wp1=376991.12 wp2=3769911.18
Laplace=4*(1+s/38000)/(s+1e-9)
