dario0603/Unipi_boost_converter/LTSpice/FDT Gvd open loop.asc

C1: cap; {C}
C2: cap; {C}
E1: e; {1/(1-{D})}
E2: e; Laplace={Vout}-({Vout}/({Ro}*(1-{D})**2))*s*{L}
E3: e; {1/(1-{D})}
E4: e; Laplace={Vout}/(1-{D})
G1: g; Laplace=({Vout}/({Ro}*(1-{D})**2))
G2: g; Laplace={Vout}/({Ro}*(1-{D}))
L1: ind; {{L}/((1-{D})**2)}
L2: ind; {{L}/((1-{D})**2)}
R1: res; {Ro}
R2: res; {Ro}
V1: voltage; 3.3
V2: voltage; 0; AC 1 0
V3: voltage; 3.3
Named nets: 0, d+, d-, Gvd1, Gvd2
.param D=0.725 L=330u C=18u Ro=1000 Vout=12
.ac dec 100 1e-2 1e6
