dario0603/Unipi_boost_converter/LTSpice/FDT open loop.asc

B1: bv; V=if(V(Vc)>V(Vtri),1,0)
C1: cap; 18µ
D1: diode; BAS3005A-02V
E1: e; 3
E2: e; 3
L1: ind; 330µ
M1: nmos; IRFH7921
R1: res; 100
R2: res; 30m
R3: res; 286m
R4: res; 20
V1: voltage; 3.3
V2: voltage; 0.7354
V3: voltage; 0.7777
V4: voltage; PULSE(0 1 0 1.667u 1p 0 1.667u)
Named nets: MOS+, 0, Vtri, Hsense, Vc
.tran 0 50m 0 1m
.model BAS3005A-02V D(Is=30u Rs=0.267 N=1.05 Cjo=15p M=0.5 VJ=0.5 Tt=1.4n Kf=0 Af=1)
Con carico 100ohm
Con carico 1000ohm
