dario0603/Unipi_boost_converter/LTSpice/SteadyState_1.asc

C1: cap; 12µ
D1: diode; 1N4148
L1: ind; 45.73µ
R1: res; 1000
S1: sw; SW1
V1: voltage; 3.3
V2: voltage; PULSE(0 1 0 1p 1p 1.25u 1.66u)
Named nets: SW+, SW-, 0
.tran 0 17m 15m 1u
.model SW1 SW(Ron=0.1 Roff=1MEG Vt=0.5)
