dario0603/Unipi_boost_converter/LTSpice/SteadyState_2 losses.asc

C1: cap; 18µ
D1: diode; BAS3005A-02V
L1: ind; 330µ
M1: nmos; IRFH7921
R1: res; 100
R2: res; 286m
R3: res; 30m
V1: voltage; 3.3
V4: voltage; PULSE(0 5 0 1n 1n 1.23u 1.66u)
Named nets: MOS+, 0
.tran 0 17m 15m 100u
.model BAS3005A-02V D(Is=30u Rs=0.267 N=1.05 Cjo=15p M=0.5 VJ=0.5 Tt=1.4n Kf=0 Af=1)
